Hao-Lion-ZJU/PixShark-V2/doc/Pixshark电路原理图.pdf

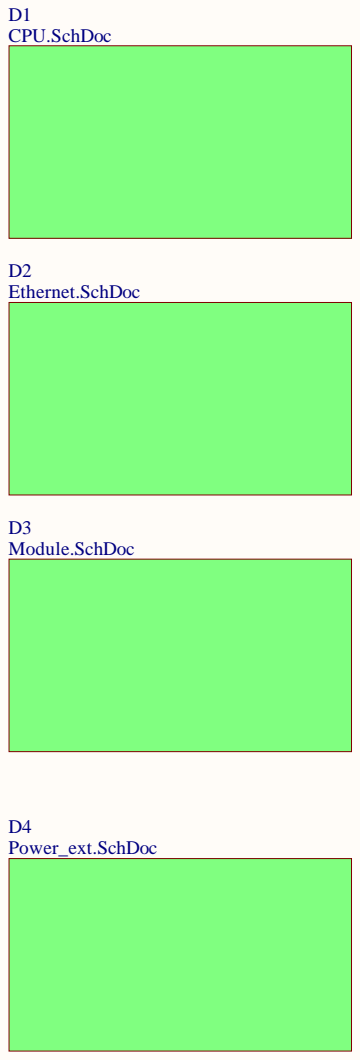
[picture p3: page 1]

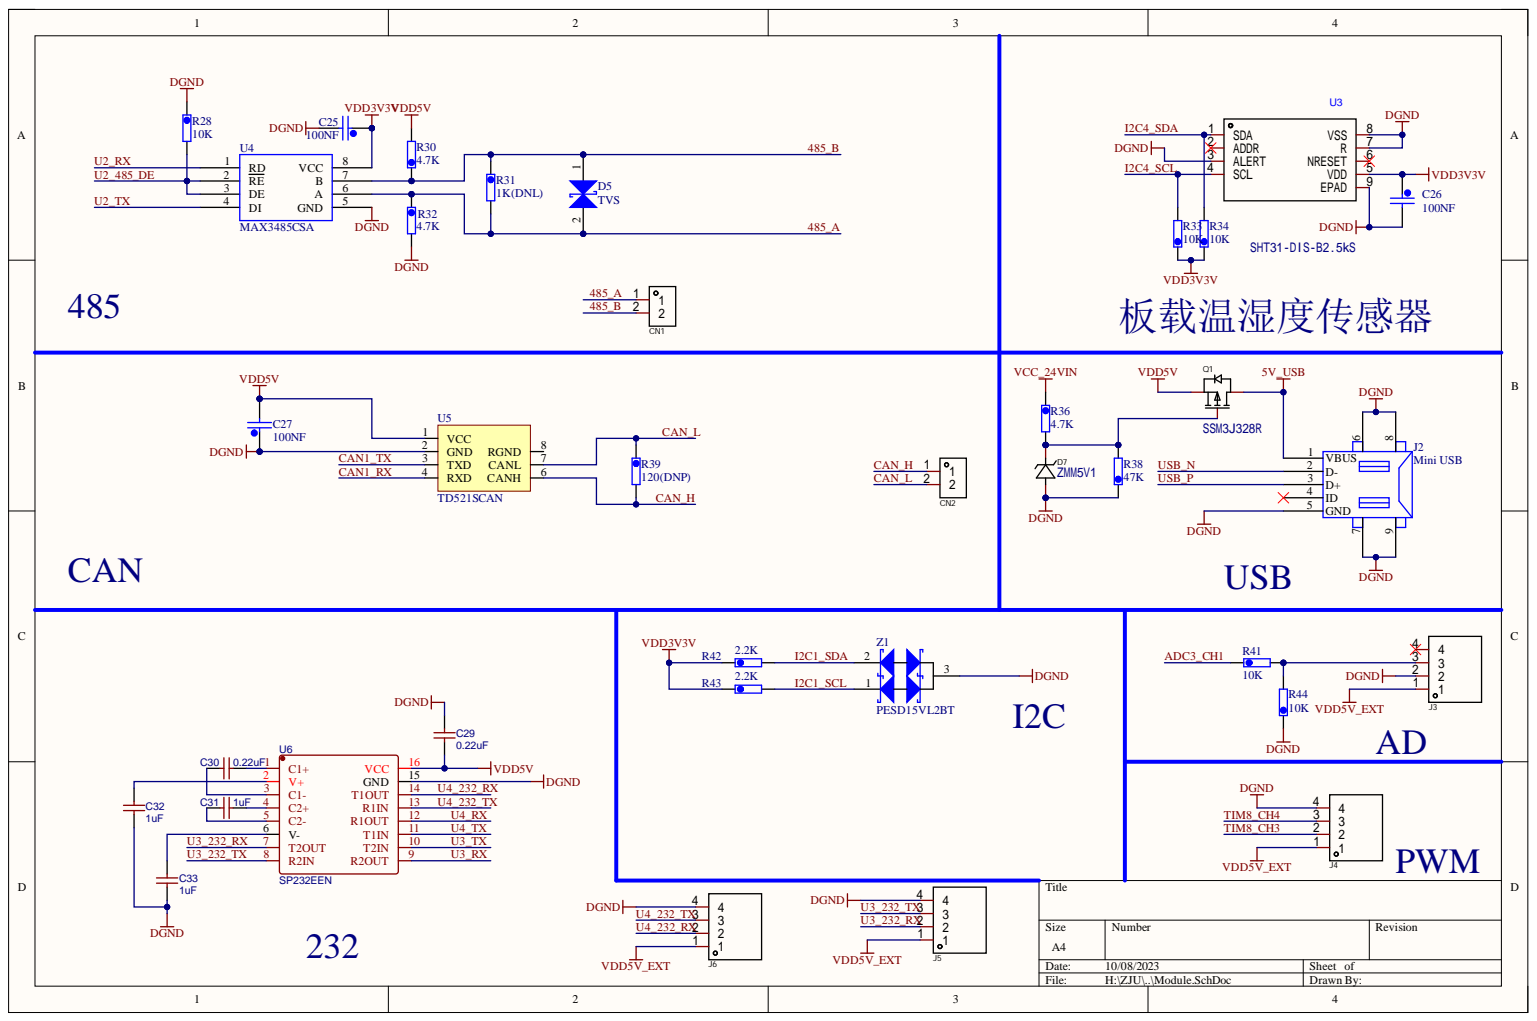
[picture p4: page 2]

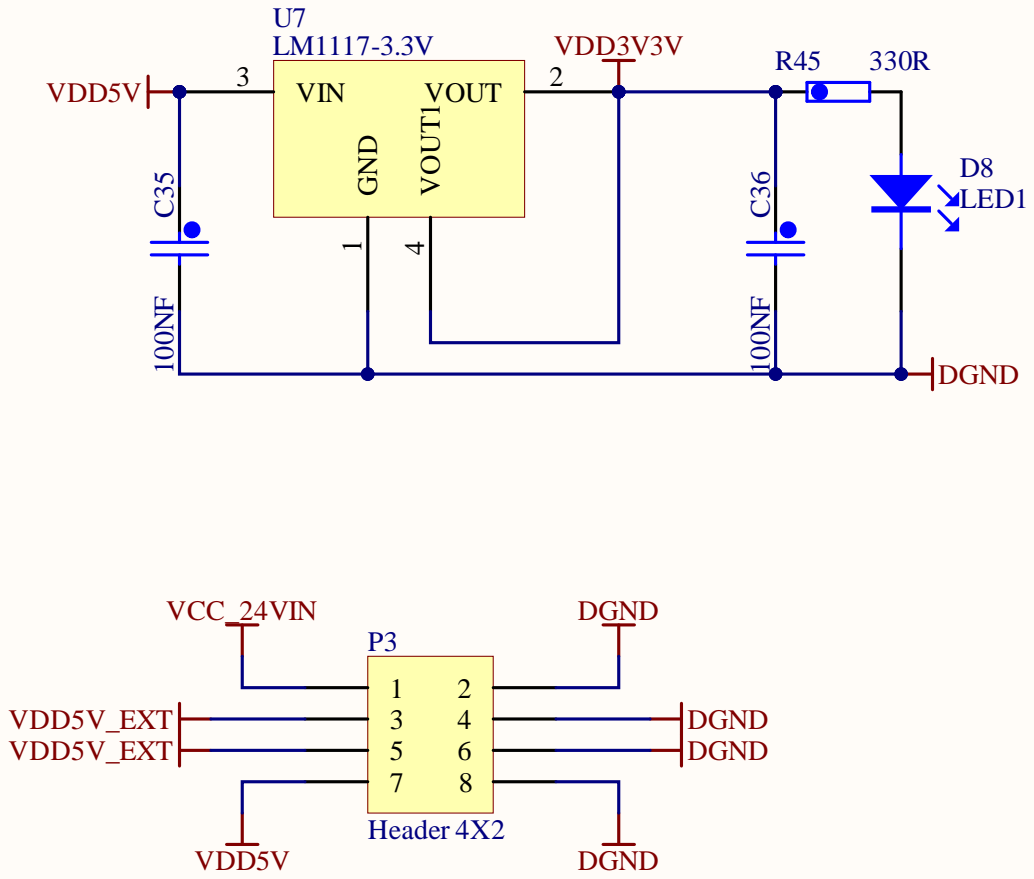
[picture p5: page 3]

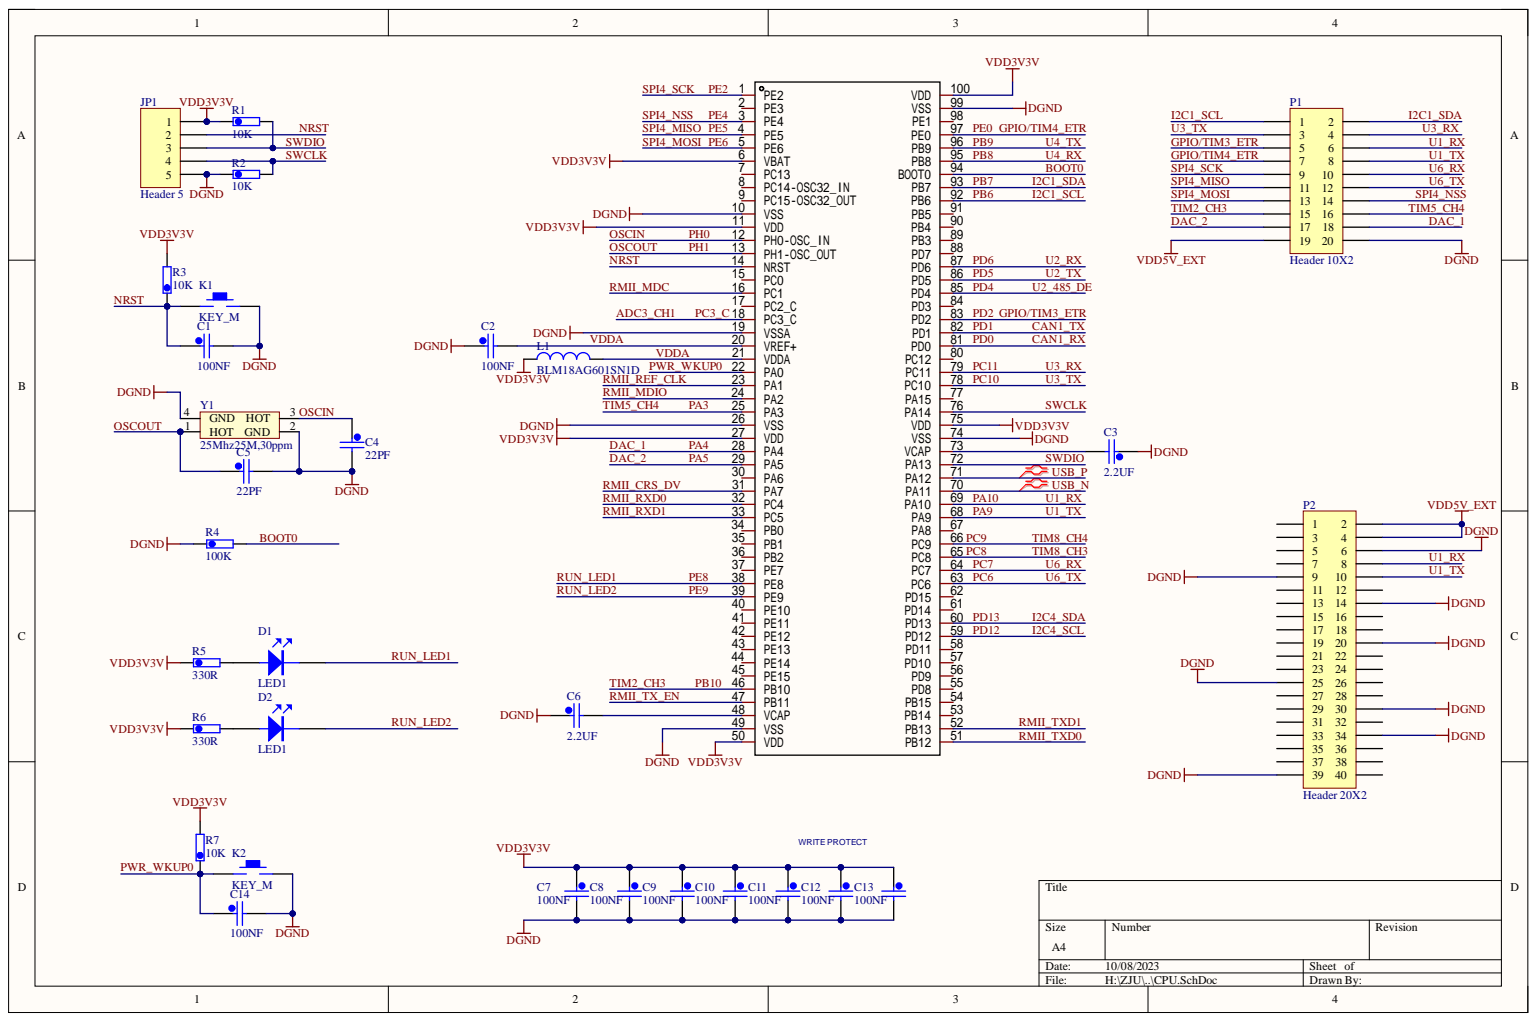
[picture p6: page 4]

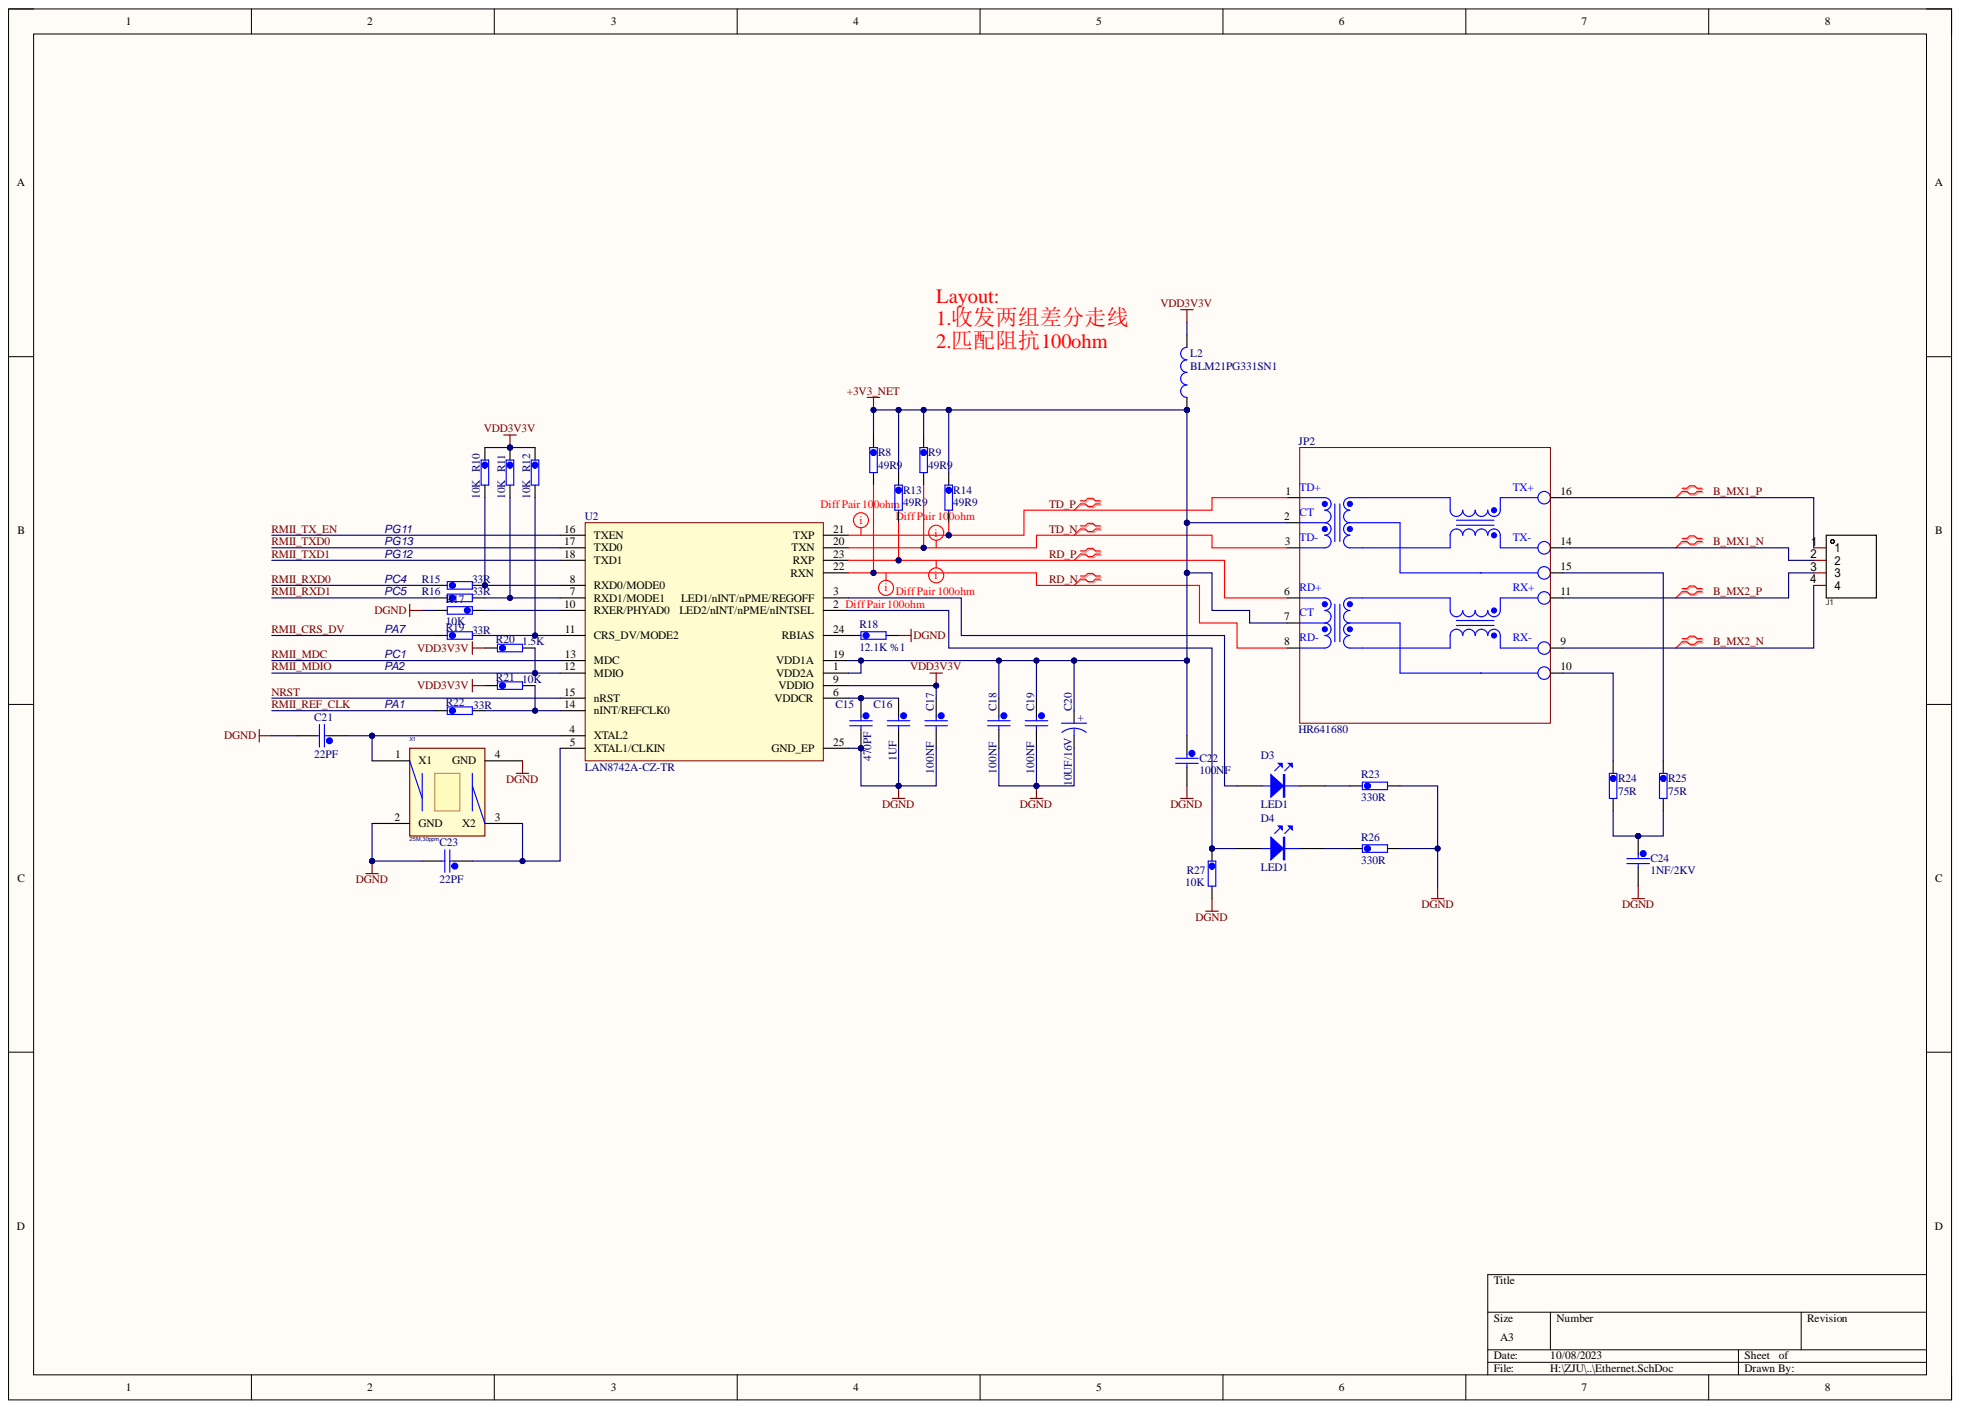
[picture p7: page 5]

X 1 5
X 1 G N G N X | D 2 | 4

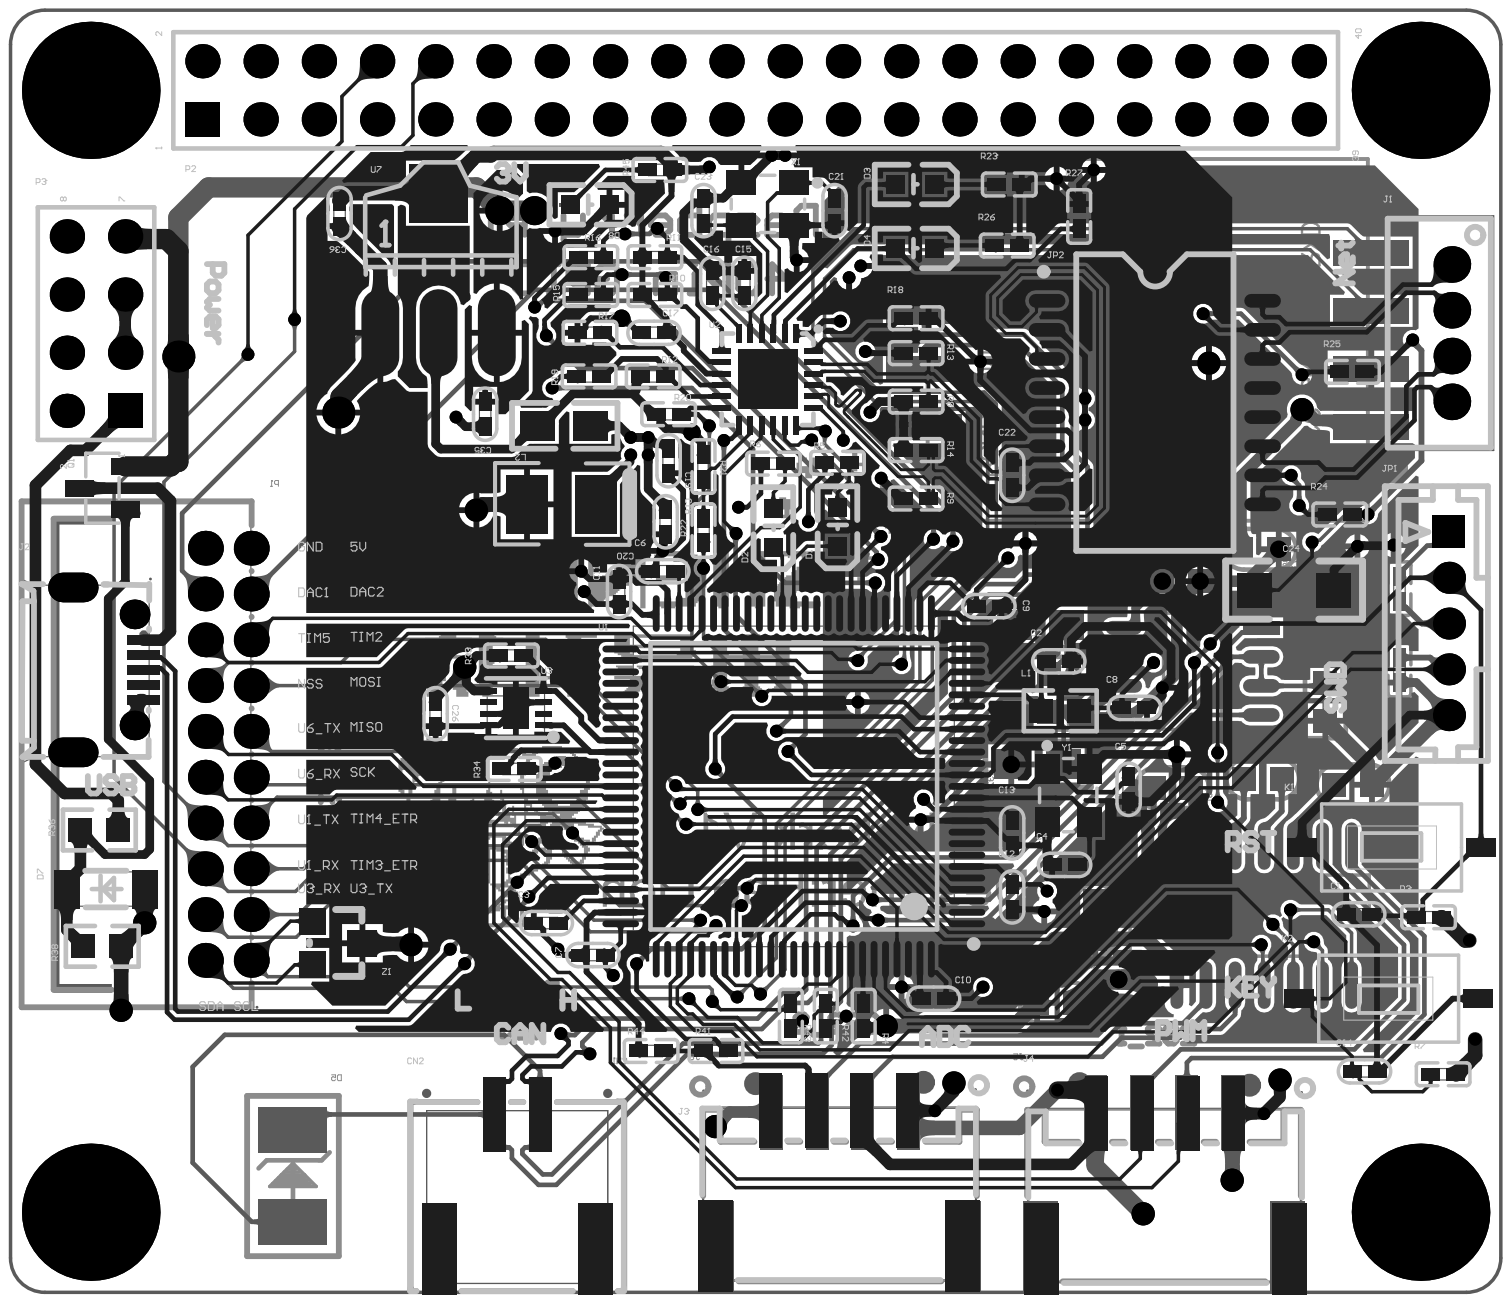
[picture p8: page 6]
