Hao-Lion-ZJU/PixShark-V2/PixShark.ioc

Mcu.UserName=STM32H743VGTx
PA0.Signal=GPXTI0
PA1.Signal=ETH_REF_CLK
PA10.Signal=USART1_RX
PA11.Signal=USB_OTG_FS_DM
PA12.Signal=USB_OTG_FS_DP
PA2.Signal=ETH_MDIO
PA4.Signal=COMP_DAC11_group
PA5.Signal=COMP_DAC12_group
PA7.Signal=ETH_CRS_DV
PA9.Signal=USART1_TX
PB10.Signal=S_TIM2_CH3
PB11.Signal=ETH_TX_EN
PB12.Signal=ETH_TXD0
PB13.Signal=ETH_TXD1
PB6.Signal=I2C1_SCL
PB7.Signal=I2C1_SDA
PB8.Signal=UART4_RX
PB9.Signal=UART4_TX
PC1.Signal=ETH_MDC
PC10.Signal=USART3_TX
PC11.Signal=USART3_RX
PC3_C.Signal=ADC3_INP1
PC4.Signal=ETH_RXD0
PC5.Signal=ETH_RXD1
PC6.Signal=USART6_TX
PC7.Signal=USART6_RX
PC8.Signal=S_TIM8_CH3
PC9.Signal=S_TIM8_CH4
PD0.Signal=FDCAN1_RX
PD1.Signal=FDCAN1_TX
PD12.Signal=I2C4_SCL
PD13.Signal=I2C4_SDA
PD2.Signal=S_TIM3_ETR
PD4.Signal=USART2_DE
PD5.Signal=USART2_TX
PD6.Signal=USART2_RX
PE0.Signal=S_TIM4_ETR
PE2.Signal=SPI4_SCK
PE4.Signal=SPI4_NSS
PE5.Signal=SPI4_MISO
PE6.Signal=SPI4_MOSI
PE8.Signal=GPIO_Output
PE9.Signal=GPIO_Output
