Hao-Lion-ZJU/PixShark-V2/Robot/servo_task.cpp

/**
  ****************************(C) COPYRIGHT 2022 ZJU****************************
  * @file       servo_task.cpp
  * @brief      servo控制任务         
  * @note       
  * @history
  *  Version    Date            Author          Modification
  *  V1.0.0     OCT-7-2023     HaoLion(郝亮亮)    1. done
  *
  @verbatim
  ==============================================================================

  ==============================================================================
  @endverbatim
  ****************************(C) COPYRIGHT 2022 ZJU****************************
  */

#include "servo_task.hpp"
#include "servo/servo.hpp"

osThreadId servo_task_handle;

uint8_t servo_angle;

serial::Serial* servo_serialPtr = nullptr;
AUSServo* ausPtr = nullptr;


void servo_init()
{
    //初始化串口
    servo_serialPtr = new serial::Serial(&huart2);
    servo_serialPtr->open(O_WRONLY);
    ausPtr = new AUSServo(servo_serialPtr, 0x00);
    ausPtr->Init();
}

static void servo_task(void * argument)
{
    servo_init();
    for(;;)
    {
        //等待控制指令
        while (ulTaskNotifyTake(pdTRUE, portMAX_DELAY) != pdPASS)
        {
        }
        ausPtr->set_servo_angle(servo_angle);
    }
    
}


void servo_task_start(void)
{
    const osThreadAttr_t  servoTask_attributes  = {
    .name = (char*)"servo",
    .stack_size = 128,
    .priority = osPriorityNormal,
    };
    servo_task_handle = osThreadNew(servo_task, NULL, &servoTask_attributes);
}
