Hao-Lion-ZJU/PixShark-V2/components/hardware/dac/dac.cpp

/** 
 *****************************Copyright (c) 2023  ZJU****************************
 * @file      : dac.cpp
 * @brief     : dac驱动文件
 * @history   :
 *  Version     Date            Author          Note
 *  V1.0.0    2023-11-30       Hao Lion        1. <note>
 *  V1.0.1    2023-12-15       Qiqi Li         1. fix some bugs
 *******************************************************************************
 * @verbatim :
 *==============================================================================
 *                                                                              
 *                                                                              
 *==============================================================================
 * @endverbatim :
 *****************************Copyright (c) 2023  ZJU****************************
 */

#include "dac/dac.hpp"

Dac::Dac(DAC_HandleTypeDef* hdac)
{
    configASSERT(hdac != nullptr);
    hdacPtr_ = hdac;
}

Dac::~Dac()
{
    stop();
}

void Dac::start()
{
    if(!isStart_)
    {
        HAL_DAC_Start(&hdac1, DAC_CHANNEL_1);
        HAL_DAC_Start(&hdac1, DAC_CHANNEL_2);
        isStart_ = true;
    }
    
}

void Dac::stop()
{
    if(isStart_)
    {
        HAL_DAC_Stop(&hdac1, DAC_CHANNEL_1);
        HAL_DAC_Stop(&hdac1, DAC_CHANNEL_2);
        isStart_ = false;
    }
}

void Dac::setvalue(uint32_t channel, uint32_t value)
{
    if(channel == DAC_CHANNEL_1)
    {
        dac_ch1_value = value;
    }
    else if(channel == DAC_CHANNEL_2)
    {
        dac_ch2_value = value;
    }
    else
    {
        configASSERT(0);
    }
    HAL_DAC_SetValue(hdacPtr_, channel, DAC_ALIGN_12B_R, value);
}
