Hao-Lion-ZJU/PixShark-V2/Robot/param_task.hpp

#ifndef PARAM_TASK_HPP
#define PARAM_TASK_HPP

#include "common.hpp"
#include "led_task.hpp"
#include "servo_task.hpp"

#ifdef __cplusplus

extern "C" {
#endif


void param_task_start(void);

#ifdef __cplusplus
}
#endif



#endif
