Hao-Lion-ZJU/PixShark-V2/Robot/subscription_task.hpp

#ifndef SUBSCRIPTION_TASK_HPP
#define SUBSCRIPTION_TASK_HPP

#include "common.hpp"
#include "crawler_task.hpp"
#include "thruster_task.hpp"

#ifdef __cplusplus

extern "C" {
#endif


void subscription_task_start(void);

#ifdef __cplusplus
}
#endif



#endif
